iiDuNoo/CubeSat-Power-System/Component Models/Spirit2U - ADCS Shelf.sldasm

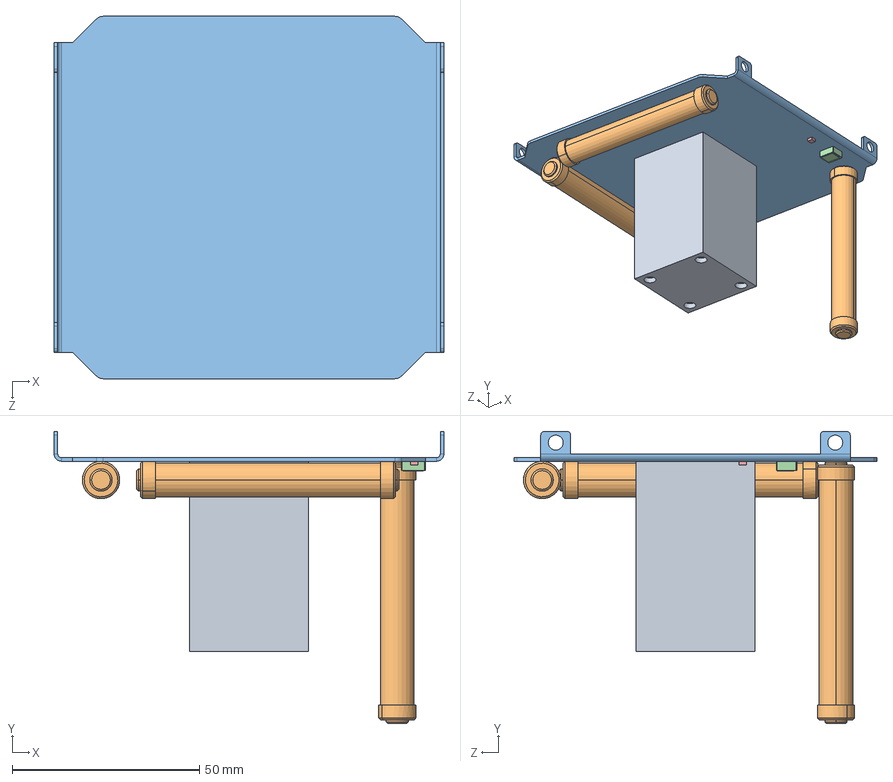
[picture p28: CAD file, 2019-11-26]
Component Models/Spirit2U - ADCS Shelf.sldasm
104.1 x 78.0 x 96.7 mm
PCM Heat Sink
NCTR-MAS-001-01.A - M002 Cubesat Torque Rod (Defeatured) x 3
Spirit2U Tranceiver Shelf 2
Gyroscope
Magnetometer
