iiDuNoo/CubeSat-Power-System/Component Models/Transceiver HS Assembly.SLDASM

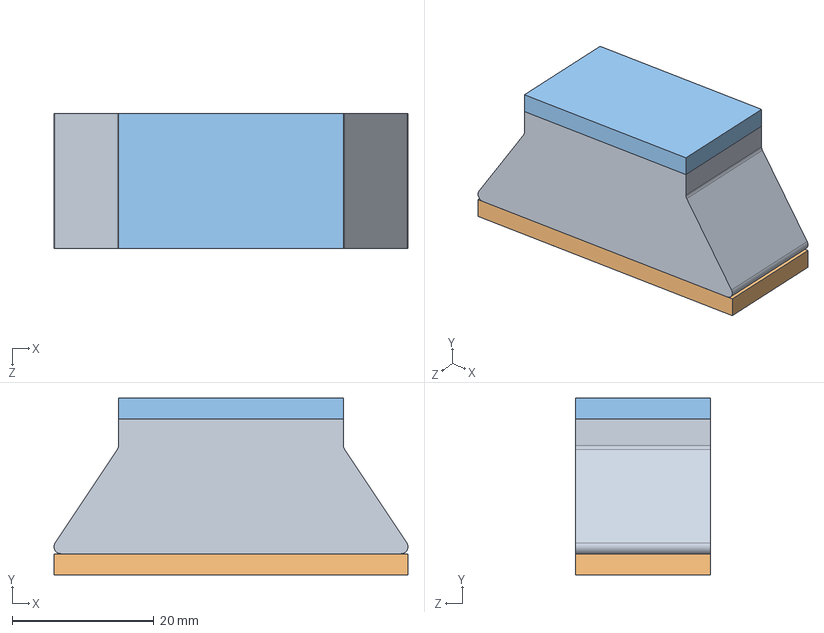
[picture p29: CAD file, 2019-11-26]
Component Models/Transceiver HS Assembly.SLDASM
50.0 x 25.0 x 19.1 mm
Transceiver HS
Transceiver HS Epoxy Bottom
Transceiver HS Epoxy Top
