iiDuNoo/CubeSat-Power-System/Component Models/Spirit2U - Battery Shelf.sldasm

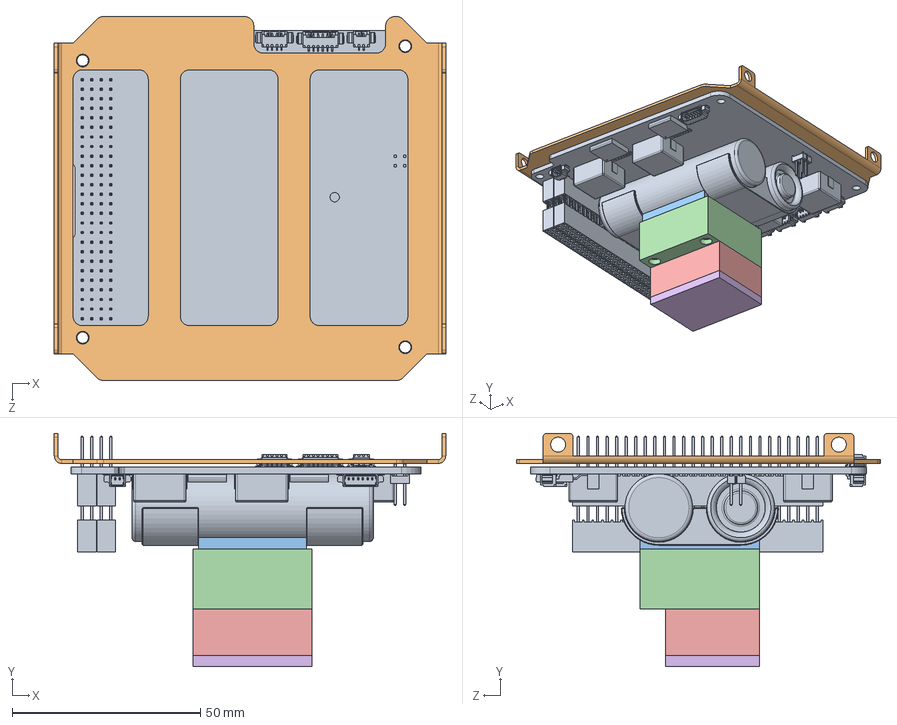
[picture p30: CAD file, 2019-11-26]
Component Models/Spirit2U - Battery Shelf.sldasm
104.1 x 62.0 x 96.7 mm
Battery
Spirit2U Battery Shelf
Spirit2U Battery Thermal Paste
Upper PCM Heat Sink
OBC Thermal Strap
OBC Thermal Paste
