iiDuNoo/CubeSat-Power-System/Component Models/Spirit2U - Frame.sldasm

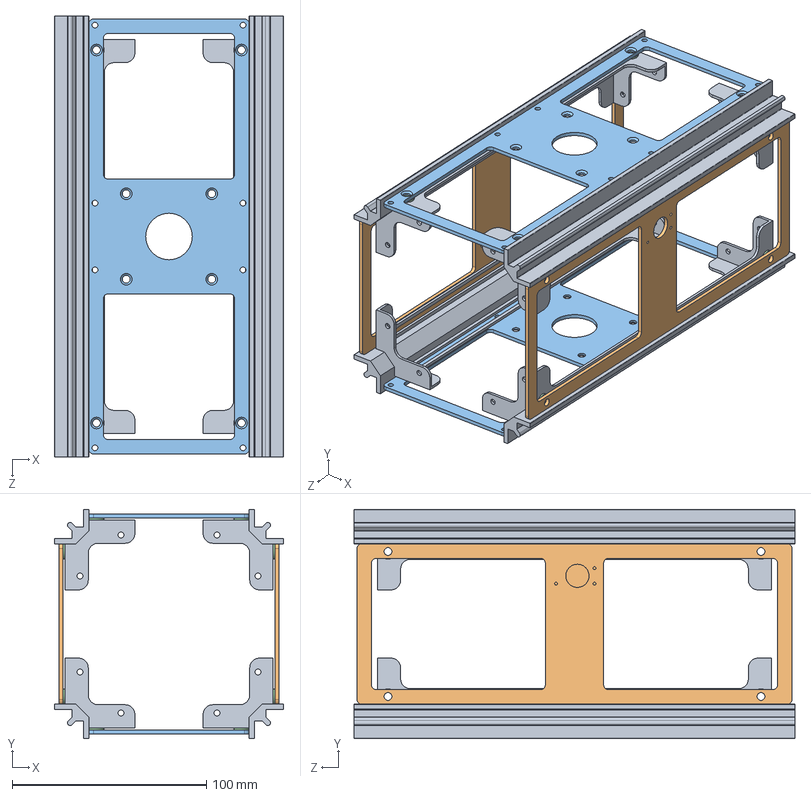
[picture p31: CAD file, 2019-11-26]
Component Models/Spirit2U - Frame.sldasm
118.0 x 118.0 x 227.0 mm
Spirit2U Rail x 4
Spirit2U Side panel A x 2
Spirit2U Side panel B x 2
93650A110_MOISTURE-RESISTANT CUSHIONING WASHER x 16
