iiDuNoo/CubeSat-Power-System/Component Models/Spirit2U - OBC Shelf.sldasm

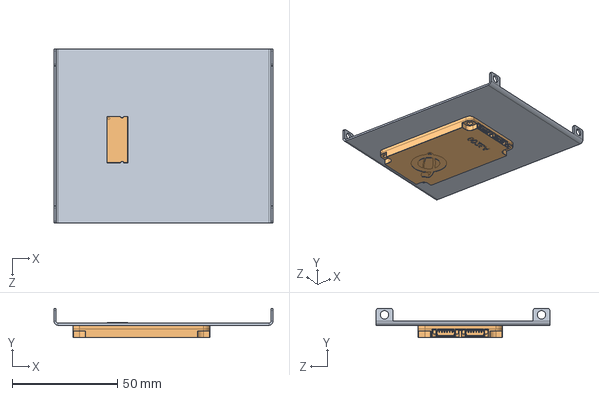
[picture p32: CAD file, 2019-11-26]
Component Models/Spirit2U - OBC Shelf.sldasm
104.1 x 13.8 x 82.6 mm
Spirit2U Shelf 1
OBC
