iiDuNoo/CubeSat-Power-System/Component Models/Magnetometer.SLDPRT

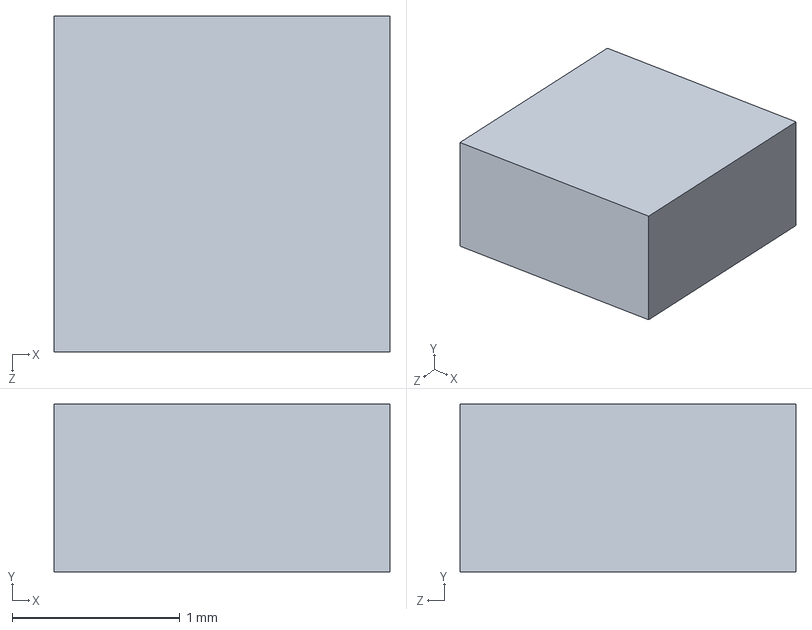
[picture p33: CAD file, 2019-11-26]
Component Models/Magnetometer.SLDPRT
2.00 x 1.00 x 2.00 mm
