iiDuNoo/CubeSat-Power-System/Component Models/Spirit2U Rail.SLDPRT

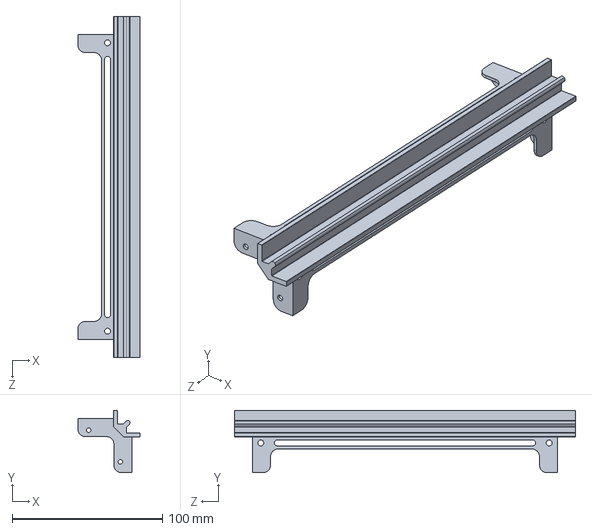
[picture p34: CAD file, 2019-11-26]
Component Models/Spirit2U Rail.SLDPRT
41.5 x 41.5 x 227.0 mm
