iiDuNoo/CubeSat-Power-System/Component Models/SolarPanel_1U.SLDPRT

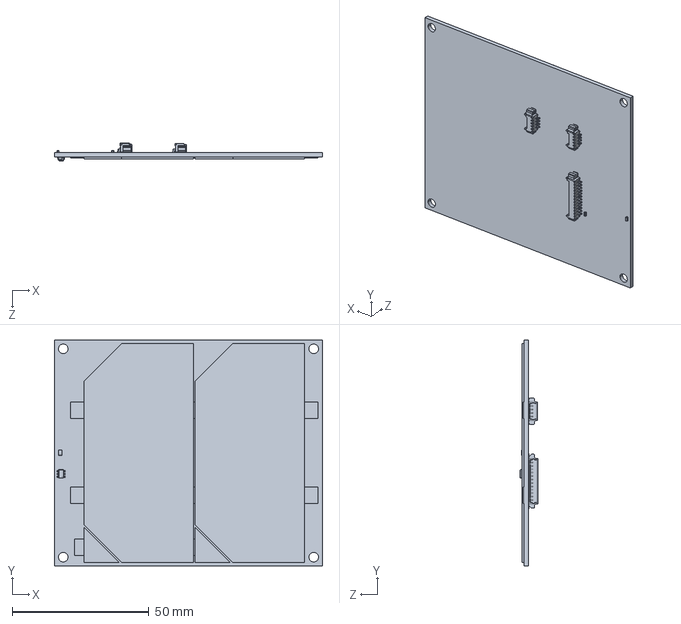
[picture p36: CAD file, 2019-11-26]
Component Models/SolarPanel_1U.SLDPRT
98.0 x 82.6 x 6.55 mm
