iiDuNoo/CubeSat-Power-System/Component Models/Transceiver HS Epoxy Bottom.SLDPRT

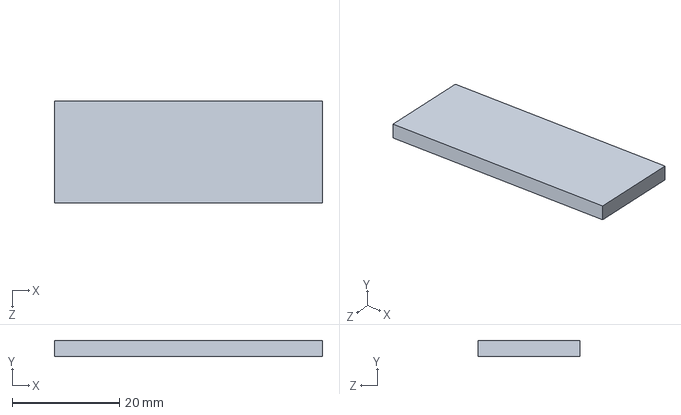
[picture p37: CAD file, 2019-11-26]
Component Models/Transceiver HS Epoxy Bottom.SLDPRT
50.0 x 3.00 x 19.1 mm
