iiDuNoo/CubeSat-Power-System/Component Models/OBC.SLDPRT

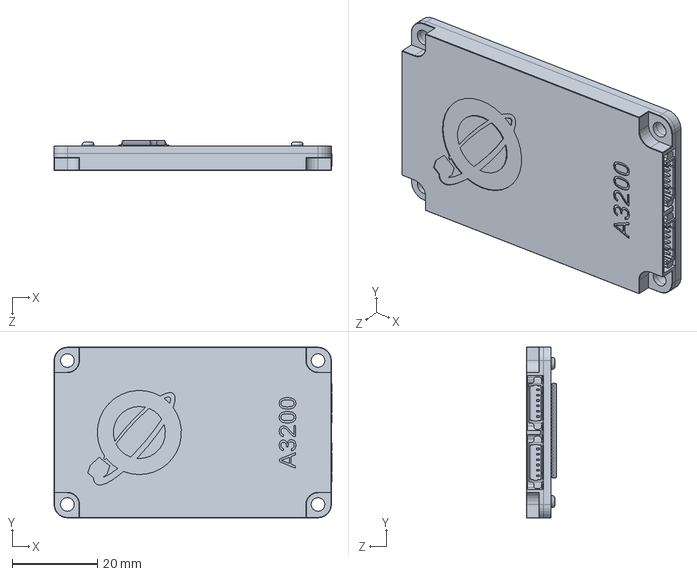
[picture p38: CAD file, 2019-11-26]
Component Models/OBC.SLDPRT
65.1 x 40.0 x 7.06 mm
