iiDuNoo/CubeSat-Power-System/Component Models/Transceiver HS Epoxy Top.SLDPRT

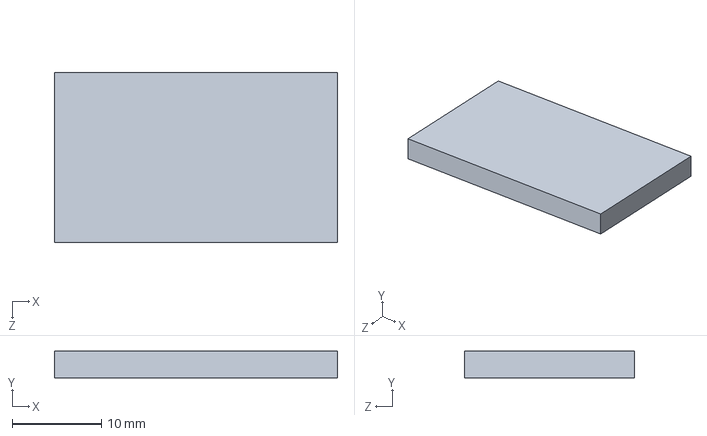
[picture p39: CAD file, 2019-11-26]
Component Models/Transceiver HS Epoxy Top.SLDPRT
31.8 x 3.00 x 19.1 mm
