iiDuNoo/CubeSat-Power-System/Component Models/NCTR-MAS-001-01.A - M002 Cubesat Torque Rod (Defeatured).SLDPRT

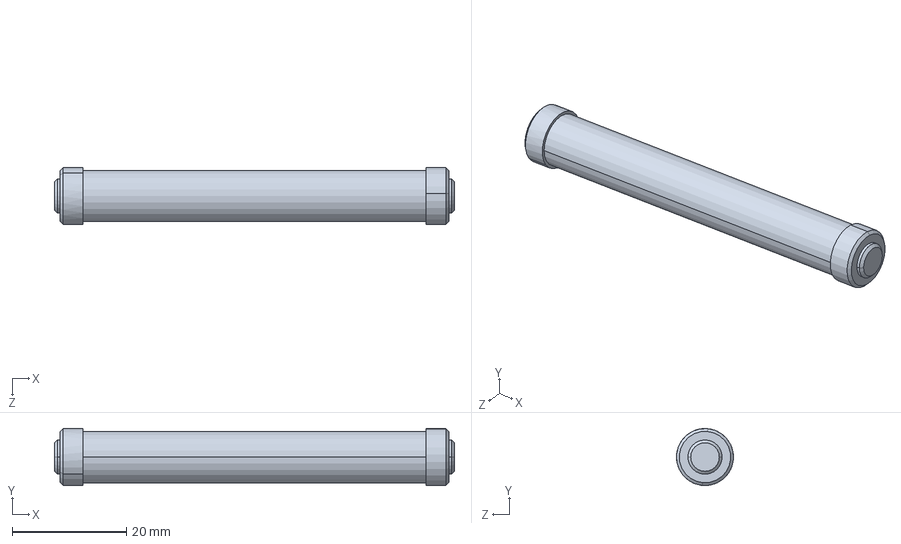
[picture p40: CAD file, 2019-11-26]
Component Models/NCTR-MAS-001-01.A - M002 Cubesat Torque Rod (Defeatured).SLDPRT
70.0 x 9.98 x 9.96 mm
