iiDuNoo/CubeSat-Power-System/Component Models/Camera Spacers.SLDPRT

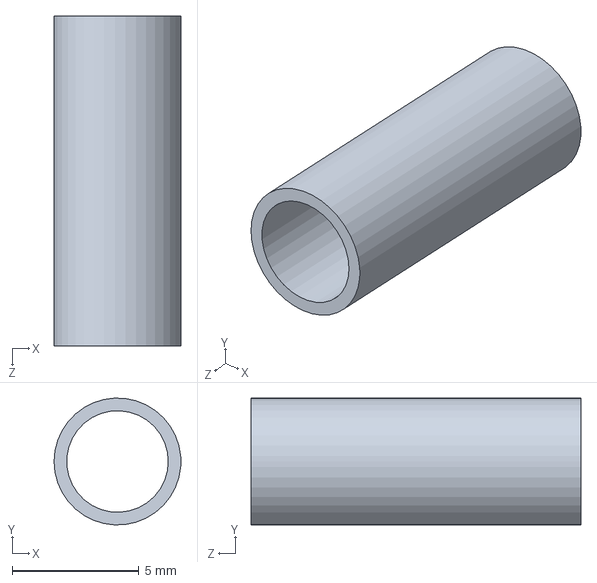
[picture p41: CAD file, 2019-11-26]
Component Models/Camera Spacers.SLDPRT
5.00 x 5.00 x 13.0 mm
