iiDuNoo/CubeSat-Power-System/Component Models/SolarPanel_TopZ.SLDPRT

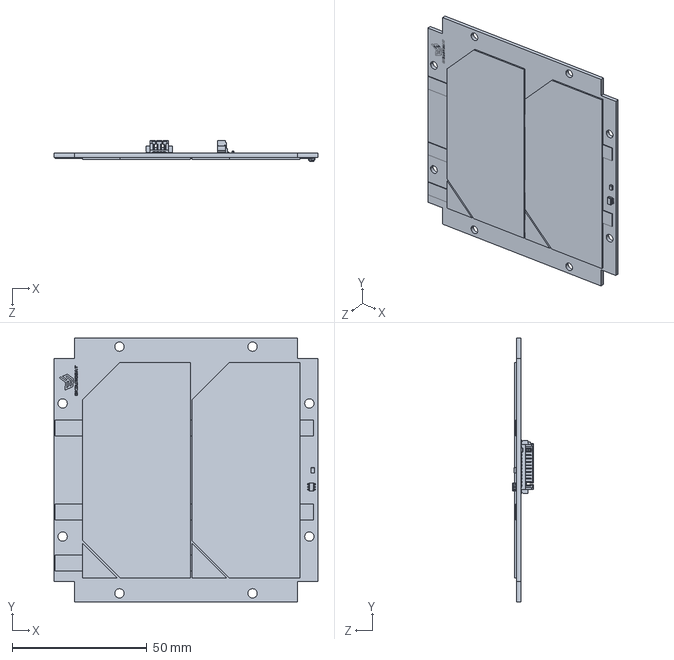
[picture p42: CAD file, 2019-11-26]
Component Models/SolarPanel_TopZ.SLDPRT
98.0 x 98.0 x 7.75 mm
