iiDuNoo/CubeSat-Power-System/Component Models/Spirit2U Side panel A.SLDPRT

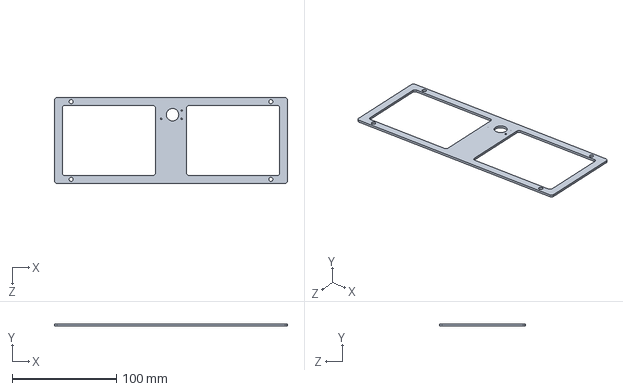
[picture p43: CAD file, 2019-11-26]
Component Models/Spirit2U Side panel A.SLDPRT
224.0 x 2.00 x 82.6 mm
