iiDuNoo/CubeSat-Power-System/Component Models/PCM Heat Sink.SLDPRT

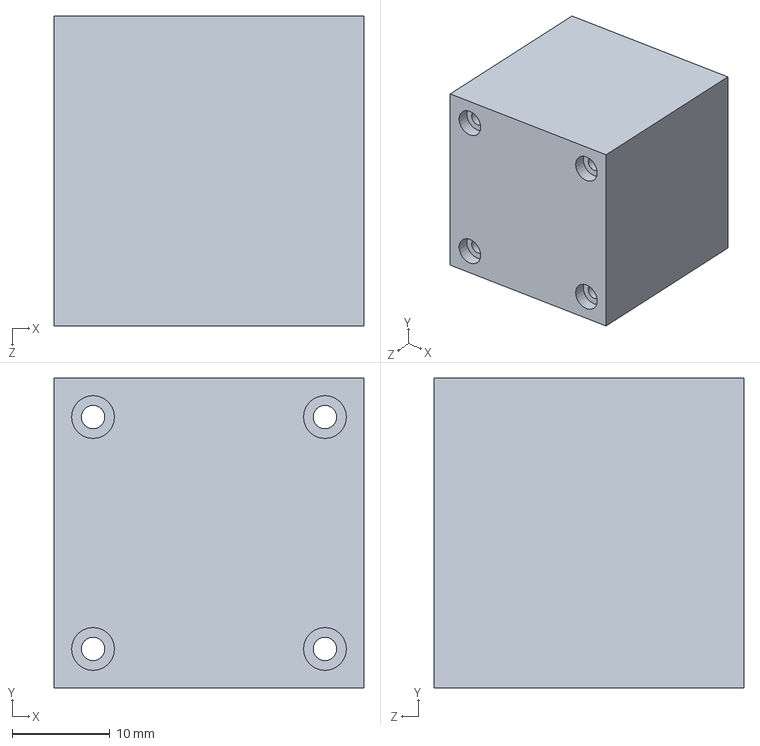
[picture p44: CAD file, 2019-11-26]
Component Models/PCM Heat Sink.SLDPRT
31.8 x 31.8 x 31.8 mm
