iiDuNoo/CubeSat-Power-System/Component Models/Spirit2U Tranceiver Shelf 2.SLDPRT

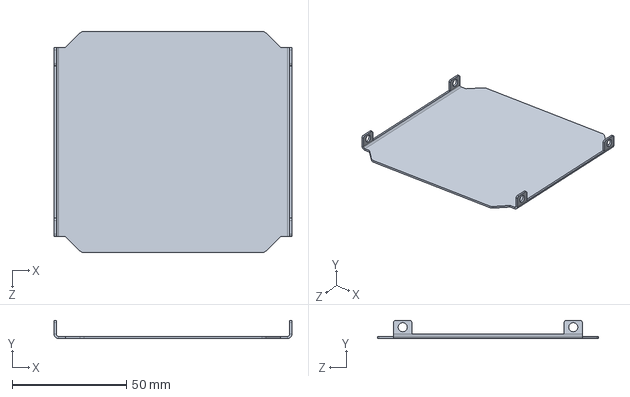
[picture p45: CAD file, 2019-11-26]
Component Models/Spirit2U Tranceiver Shelf 2.SLDPRT
104.1 x 8.00 x 96.7 mm
