iiDuNoo/CubeSat-Power-System/Component Models/Transceiver HS.SLDPRT

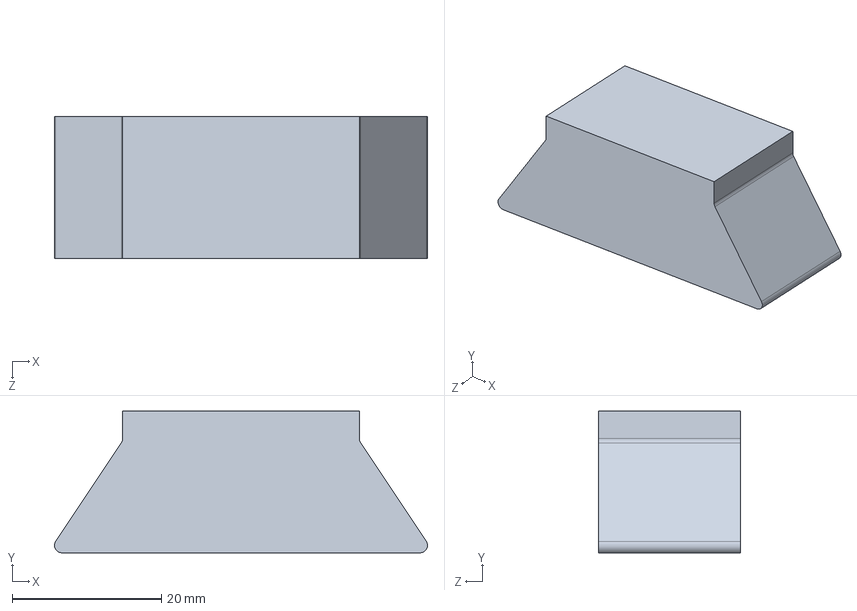
[picture p46: CAD file, 2019-11-26]
Component Models/Transceiver HS.SLDPRT
50.0 x 19.0 x 19.1 mm
