iiDuNoo/CubeSat-Power-System/Component Models/Gyroscope.SLDPRT

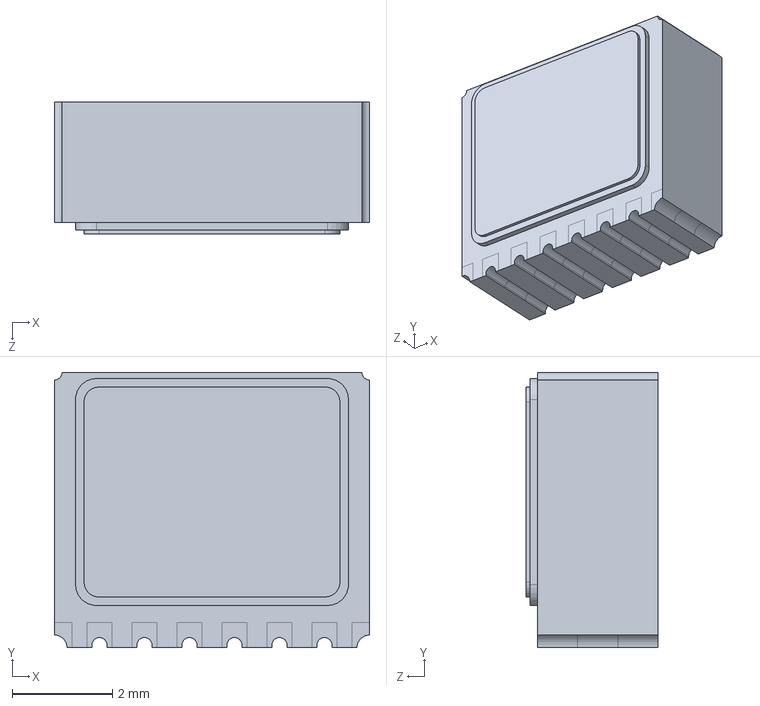
[picture p47: CAD file, 2019-11-26]
Component Models/Gyroscope.SLDPRT
6.30 x 5.50 x 2.63 mm
