iiDuNoo/CubeSat-Power-System/Component Models/OBC Thermal Paste.SLDPRT

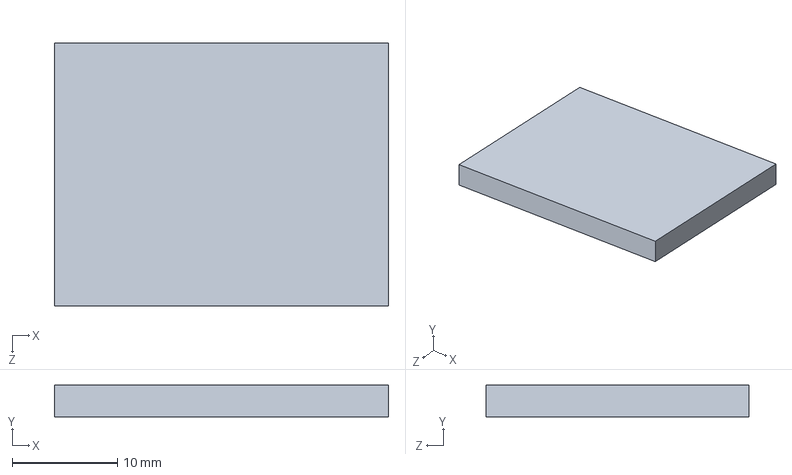
[picture p48: CAD file, 2019-11-26]
Component Models/OBC Thermal Paste.SLDPRT
31.8 x 3.00 x 25.0 mm
