iiDuNoo/CubeSat-Power-System/Component Models/s_band_type_I_3D.SLDPRT

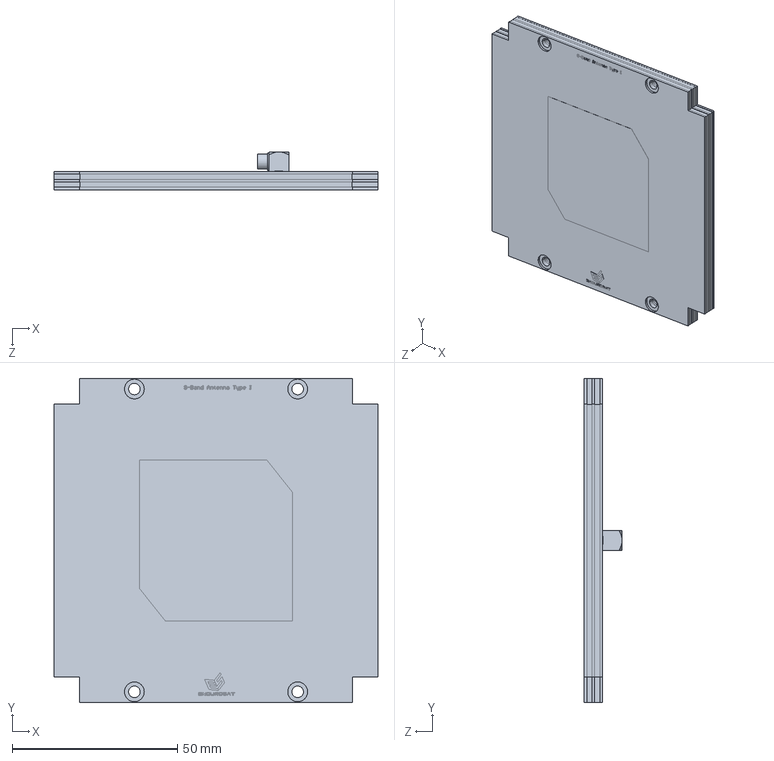
[picture p49: CAD file, 2019-11-26]
Component Models/s_band_type_I_3D.SLDPRT
98.0 x 98.0 x 11.6 mm
