iiDuNoo/CubeSat-Power-System/Component Models/NCSS-MAS-001-01.A - Cubesat Sun Sensor (Defeatured).SLDPRT

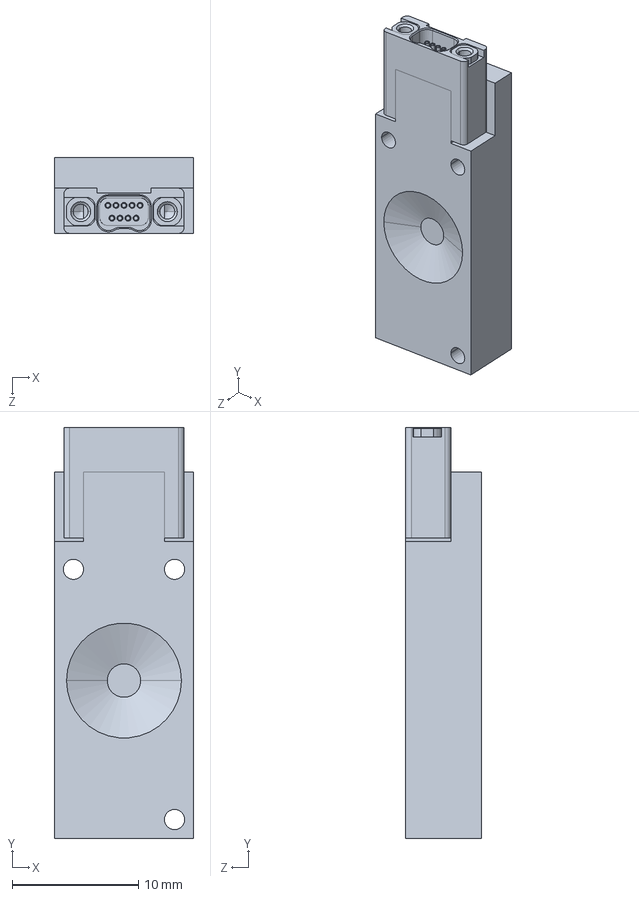
[picture p50: CAD file, 2019-11-26]
Component Models/NCSS-MAS-001-01.A - Cubesat Sun Sensor (Defeatured).SLDPRT
11.0 x 32.5 x 6.00 mm
