iiDuNoo/CubeSat-Power-System/Component Models/Spirit2U Side panel B.SLDPRT

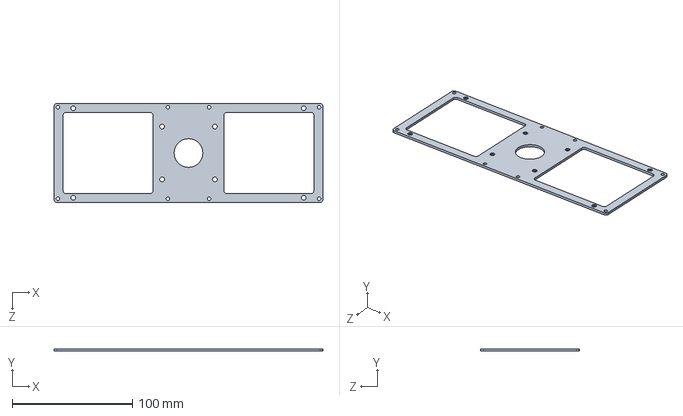
[picture p51: CAD file, 2019-11-26]
Component Models/Spirit2U Side panel B.SLDPRT
224.0 x 2.00 x 82.6 mm
