iiDuNoo/CubeSat-Power-System/Component Models/Spirit2U Shelf 1.SLDPRT

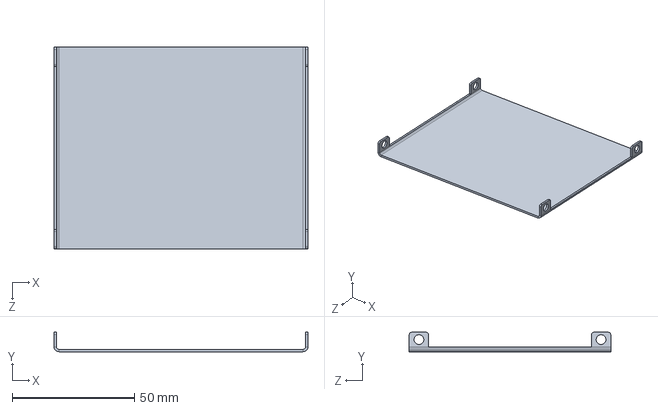
[picture p52: CAD file, 2019-11-26]
Component Models/Spirit2U Shelf 1.SLDPRT
104.1 x 8.00 x 82.6 mm
