iiDuNoo/CubeSat-Power-System/Component Models/OBC Thermal Strap.SLDPRT

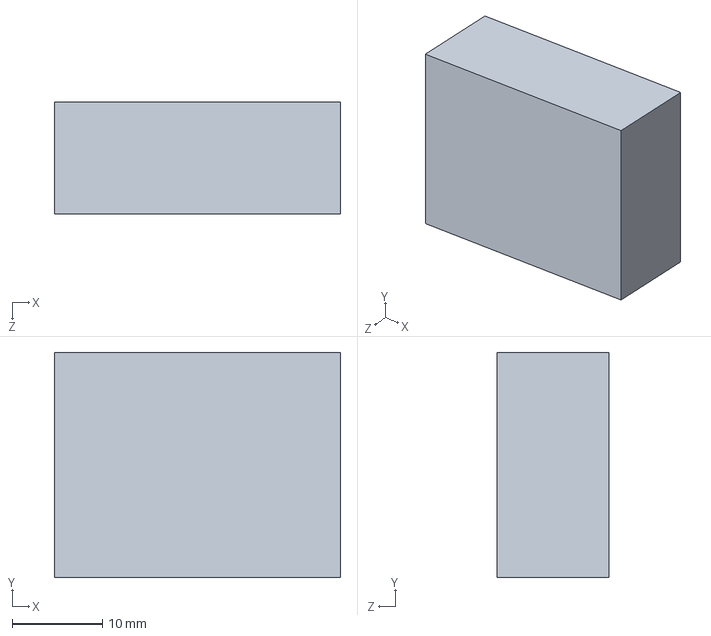
[picture p53: CAD file, 2019-11-26]
Component Models/OBC Thermal Strap.SLDPRT
31.8 x 25.0 x 12.4 mm
