iiDuNoo/CubeSat-Power-System/Component Models/Upper PCM Heat Sink.SLDPRT

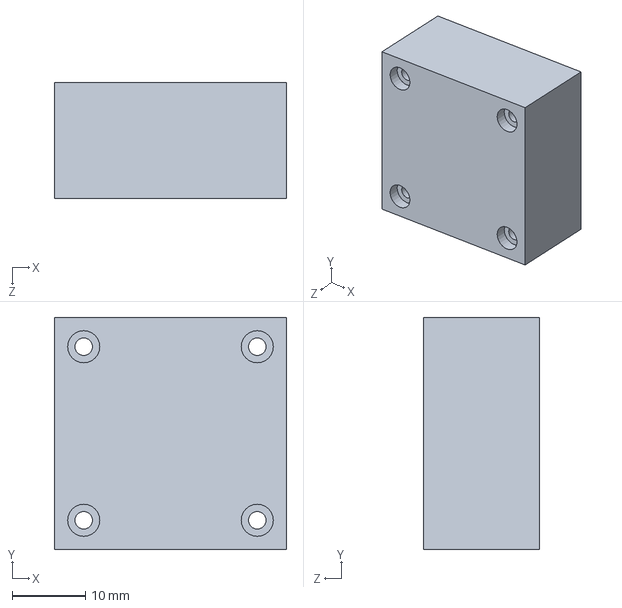
[picture p54: CAD file, 2019-11-26]
Component Models/Upper PCM Heat Sink.SLDPRT
31.8 x 31.8 x 15.9 mm
