iiDuNoo/CubeSat-Power-System/Component Models/Spirit2U Battery Thermal Paste.SLDPRT

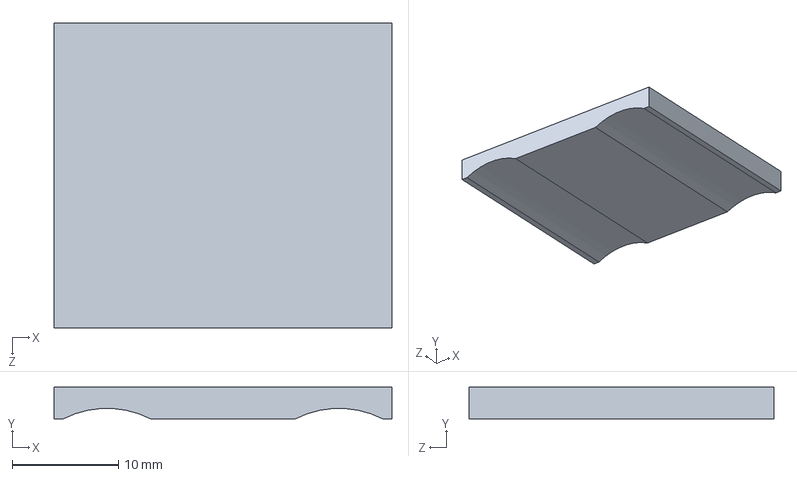
[picture p55: CAD file, 2019-11-26]
Component Models/Spirit2U Battery Thermal Paste.SLDPRT
31.8 x 3.00 x 28.7 mm
