iiDuNoo/CubeSat-Power-System/(list of files, cad)

Other CAD files:
Component Models/93650A110_MOISTURE-RESISTANT CUSHIONING WASHER.SLDPRT
Component Models/Spirit2U Battery Shelf.SLDPRT
