iiDuNoo/CubeSat-Power-System/Orbit Analysis/test2.csv

# Created by Octave 5.1.0, Thu Feb 28 15:03:58 2019 GMT <unknown@LAPTOP-BOURASSA>
# name: test
# type: matrix
# rows: 626
# columns: 4
 3 44379.116670000003 44379.120139999999 317
 1 44379.179859999997 44379.182639999999 338
 3 44379.182639999999 44379.1875 384
 1 44379.246529999997 44379.25 364
 3 44379.25 44379.25417 364
 4 44379.309029999997 44379.311110000002 299
 2 44379.311110000002 44379.313889999998 352
 1 44379.313889999998 44379.31667 274
 3 44379.31667 44379.321530000001 383
 4 44379.375 44379.377079999998 385
 2 44379.377079999998 44379.381249999999 385
 1 44379.381249999999 44379.384030000001 314
 3 44379.384030000001 44379.388189999998 339
 4 44379.442360000001 44379.444439999999 373
 2 44379.444439999999 44379.447919999999 383
 1 44379.447919999999 44379.452080000003 386
 4 44379.509030000001 44379.511109999999 386
 2 44379.511109999999 44379.514580000003 315
 1 44379.51597 44379.517359999998 124
 4 44379.576390000002 44379.579859999998 327
 3 44380.07847 44380.080560000002 197
 1 44380.141669999997 44380.143750000003 225
 3 44380.143750000003 44380.148609999997 383
 1 44380.206939999996 44380.211109999997 382
 3 44380.211109999997 44380.215279999997 368
 4 44380.271529999998 44380.272219999999 153
 2 44380.272219999999 44380.275000000001 307
 1 44380.275000000001 44380.277779999997 299
 3 44380.277779999997 44380.282639999998 374
 4 44380.336810000001 44380.338889999999 380
 2 44380.338889999999 44380.342360000002 382
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
 2 44408.811110000002 44408.813889999998 338
 1 44408.813889999998 44408.81667 279
 3 44408.81667 44408.820829999997 377
 4 44408.875 44408.877079999998 383
 2 44408.877079999998 44408.881249999999 382
 1 44408.881249999999 44408.884030000001 298
 3 44408.884030000001 44408.887499999997 353
 4 44408.942360000001 44408.943749999999 371
 2 44408.943749999999 44408.947220000002 382
 1 44408.947220000002 44408.952080000003 381
 4 44409.009030000001 44409.011109999999 381
 2 44409.011109999999 44409.014580000003 330
 1 44409.01528 44409.017359999998 218
 4 44409.075689999998 44409.079859999998 343
 3 44409.579169999997 44409.579859999998 81
 1 44409.641669999997 44409.643060000002 125
 3 44409.643750000003 44409.647920000003 378
