iiDuNoo/CubeSat-Power-System/(commit log)

2019-11-26 Add files via upload
    Solidworks Model Images of EPS and mounting connections.
2019-11-26 Add files via upload
    Final handoff report on the electrical power system capabilities of the Spirit CubeSat.
2019-11-26 Add files via upload
    Summary presentation on the Spirit Power System
2019-11-26 Add files via upload
    Solidworks Component Model Files
    [93650A110_MOISTURE-RESISTANT CUSHIONING WASHER.SLDPRT, Camera Spacers.SLDPRT, Gyroscope.SLDPRT, Magnetometer.SLDPRT, NCSS-MAS-001-01.A - Cubesat Sun Sensor (Defeatured).SLDPRT, NCTR-MAS-001-01.A - M002 Cubesat Torque Rod (Defeatured).SLDPRT, OBC Thermal Paste.SLDPRT, OBC Thermal Strap.SLDPRT]
2019-11-26 Add files via upload
    Orbital analysis from s-band compatible stations in Canada, measuring available downlink time.
    [Access times.xlsx, Satellite-ISS_UNITY_25575-To-Facility-Edmonton Access.csv, Satellite-ISS_UNITY_25575-To-Facility-Halifax Access.csv, Satellite-ISS_UNITY_25575-To-Facility-London Access.csv, Satellite-ISS_UNITY_25575-To-Facility-Montreal Access.csv, Satellite-ISS_UNITY_25575-To-Facility-Saskatoon Access.csv, Satellite-ISS_UNITY_25575-To-Facility-St_Johns Access.csv, Satellite-ISS_UNITY_25575-To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]
2019-11-26 Add files via upload
    Flowchart plan for subsystem handling on-board the cubesat.
2019-11-26 Add files via upload
    Operational Modes and their power budget for each component.
